ImprobableStudios/Feather_TFT_LoRa_Sniffer/img/Data.JPG

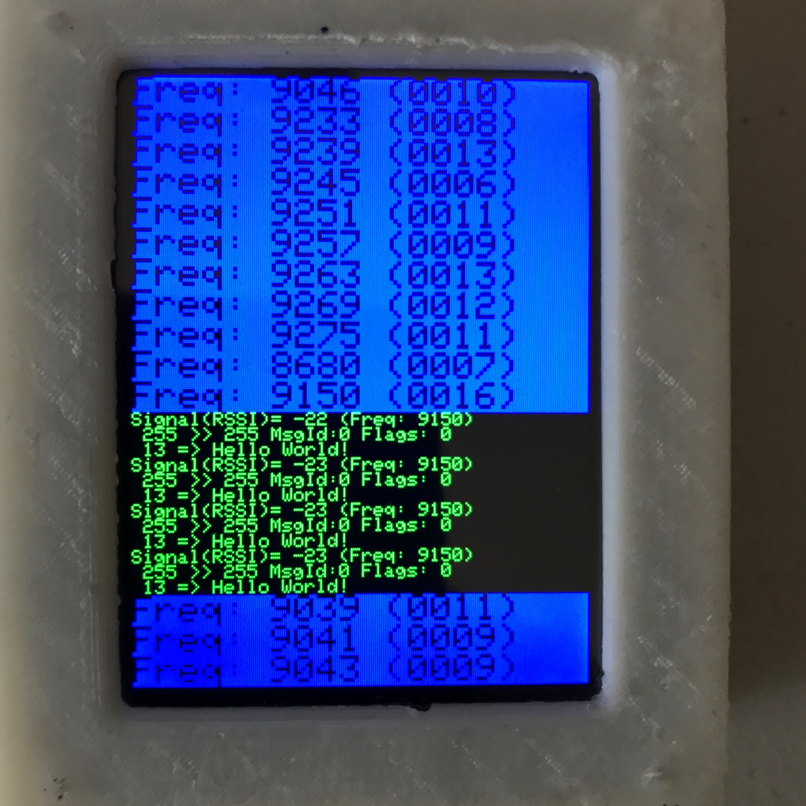
img/Data.JPG
